harmsel/CruiseControl/images/3Drender2.jpg

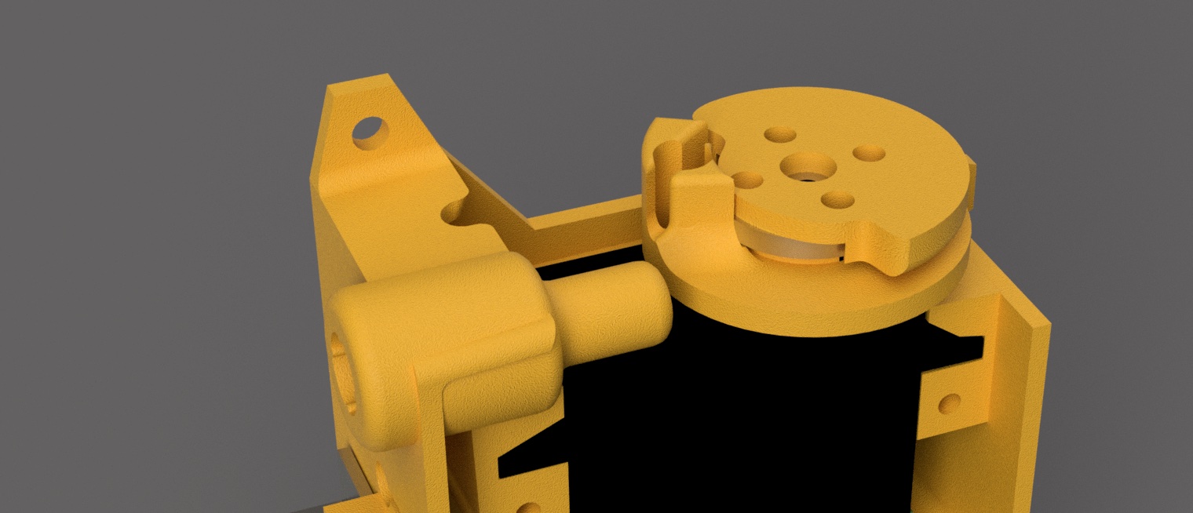
images/3Drender2.jpg
