harmsel/CruiseControl/(commit log)

2025-05-15 eerste submit - dit is het begin
    De meeste dingen werkte al een beetje.
2025-05-15 de readme eerste versie
2025-05-17 In de auto getest - pulscounter Werkt
    In de auto getest. De pulscounter werkt. Pulsecounter naar 1 seconde gezet. De waarden bij een aantal km erbij gezet
2025-05-17 Deze werkt nu goed
    servo houdt alleen zijn stand niet
2025-05-17 hernoemd, want handgas is een betere naam
2025-05-17 nu elke loop de servo stand setten
2025-06-29 versie met nieuwe servo en mechanisme
2025-06-29 eenvoudige versie die eerst moet werken
    Zonder + en -. met piepjes
2025-07-09 Deze CC regeling doet het!
    Test met hilde op de snelweg. Nu werkt dit fijn. De meetinterval veranderd naar elke halve seconce
2025-07-09 cruisecontroll werkt, alleen plussen en minnen nog niet helemaal
    Ook de led werkt nog niet
2025-07-09 Snelweg getest, werkende plus en min knoppen
    Koppeling werkt nog niet.
    Nog toevoegen dat hij pas aan mag bij een minimale snelheid
2025-07-11 timer voor + en - knoppen naar 500 ms
2025-07-15 Een optimalisatie van Gemini (2.5 pro) - met PID regeling
2025-07-15 Update CruiseControl1.ino
    Weer terug naar de mika versie met een kleine meet en regel interval (200ms)_
2025-07-20 Create cruiseControl.ino
    versie tijdens het rijden naar frankrijk. Hilde was heel tevreden. zelfs in de heuvels.
2025-07-20 Update cruiseControl.ino
    door hilde goedgekeurd, nu klapt hij er uit als de snelheid 9km kleiner is dan de ingestelde snelheid
2025-08-10 terugweg in zwitserland
    met een grotere hysteresis werkt het nu heel fijn
2025-08-14 kleine aanpassingen - rijden richting huis
    - Versnelfactor naar 0.8 ipv 0.6.
    Piepjes minder hard.
    Hij klapt er nu pas uit bij een verschil van 10 km
2026-03-29 Tijd tussen de puls meting, PID en meer - nog niet getest
    Nu meet hij niet meer aantal pulsen per seconde, maar de tijd tussen de pulsen, dus veel sneller! Kijken of dit werkt, anders terug naar de vorige versie
2026-04-05 werkt goed, iets rommelig nog
    pas evt
    float correctie = fout * 0.6; weer aan naar 0.8
    [CruiseControl.ino]
2026-04-06 kleine correctie, nog niet getest
    [CruiseControl.ino]
2026-04-06 hij doet niet nog een servo update
    na remmen/koppeleing gelijk stoppen met de servo aanturen
